adilet2109/current-sensor/README.md

# current-sensor
Bare-metal code base for current sensor board
