adilet2109/current-sensor/hardware/kicad_pulse_supply-rev-C/pcbway_production/T-B5W519245A-3sets-cc_laser_supply_rev-B.kicad_pcb_bom(2024-01-31).xls

PCBWay Bom Quotation, Product No.:T-B5W519245A
Item # | *Designator | *Qty | *Mfg Part # | Description / Value | *Package/Footprint | Mounting Type | Substitute | Assembly requirement | *Unit Price(3 sets) | *Total | *Delivery Time | *Actual Purchase Mfg Part # | *PCBWay Note | Customer Reply | PCBWay Update
1 | C1, C3 | 2 |  | 10u『 』10 µF +/- 20% Ceramic Capacitor | C_0805_2012Metric_Pad1.18x1.45mm_HandSolder | smt |  |  | $0.093 | $0.558 |  | CC0805MRX5R5BB106 |  | OK
2 | C10, C11, C12, C8, C9 | 5 | C5750X7R1V476M230KC | 47u『 』47 µF ±20% 35V Ceramic Capacitor X7R 2220 (5750 Metric) | C_2220_5650Metric | smt | NO |  | $5.501 | $82.515 | 7-10 Workdays
3 | C13 | 1 |  | 22m | CP_Radial_D35.0mm_P10.00mm_SnapIn | tht |  | dnp |  |  |  |  | [DNP不要贴]; | OK
4 | C14, C23, C24, C29, C32, C35 | 6 |  | 100n『 』0.1 µF +/- 20% Ceramic Capacitor | C_0603_1608Metric_Pad1.08x0.95mm_HandSolder | smt |  |  | $0.023 | $0.414 |  | CC0603MRX7R9BB104 |  | OK
5 | C15, C16, C20, C5, C53, C57 | 6 |  | 1u『 』1 µF +/- 20% Ceramic Capacitor | C_0603_1608Metric_Pad1.08x0.95mm_HandSolder | smt |  |  | $0.039 | $0.702 |  | CC0603MRX5R5BB105 |  | No, use UMK107BJ105KA-T or other 25V
6 | C17, C18, C2, C39, C4, C40, C41, C42, C43, C51, C52, C59, C6, C7 | 14 |  | 0u1『 』0.1 µF +/- 20% Ceramic Capacitor | C_0603_1608Metric_Pad1.08x0.95mm_HandSolder | smt |  |  | $0.010 | $0.420 |  | CC0603MRX7R8BB104 |  | OK
7 | C19, C21, C22 | 3 |  | 4u7『 』4.7 µF +/- 20% Ceramic Capacitor | C_0805_2012Metric_Pad1.18x1.45mm_HandSolder | smt |  |  | $0.125 | $1.125 |  | CC0805MKX7R8BB475 |  | OK
8 | C25, C26, C30, C33, C36 | 5 |  | 1u5『 』1.5 µF +/- 20% Ceramic Capacitor | C_0603_1608Metric_Pad1.08x0.95mm_HandSolder | smt |  |  | $0.060 | $0.900 |  | TCC0603X5R155M250CT |  | OK if 25V or higher. If not use C1608X5R1E155K080AB
9 | C27, C28, C31, C34, C37 | 5 |  | 10n『 』10 nF +/- 20% Ceramic Capacitor | C_0603_1608Metric_Pad1.08x0.95mm_HandSolder | smt |  |  | $0.442 | $6.630 |  | CX0603MRX7R9BB103 |  | OK
10 | C38 | 1 |  | 4u7『 』4.7 µF +/- 20% Ceramic Capacitor | C_0603_1608Metric_Pad1.08x0.95mm_HandSolder | smt |  |  | $0.324 | $0.972 |  | CC0603MRX7R5BB475 |  | NO, use 25V or C1608X5R1E475K080AC
11 | C44, C54, C55, C56 | 4 |  | 10u『 』10 µF +/- 20% Ceramic Capacitor | C_1206_3216Metric_Pad1.33x1.80mm_HandSolder | smt |  |  | $0.082 | $0.984 |  | CC1206MRY5V6BB106 |  | NO, use 25V or CL31A106KBHNNNE
12 | C45 | 1 | EEH-ZA1H680P | 68u『 』68 µF 50 V Aluminum - Polymer Capacitors Radial, Can - SMD 30mOhm 10000 Hrs @ 105°C | PCAP_EEHZ_F_PAN | smt | YES |  | $1.008 | $3.024
13 | C46, C49 | 2 |  | 0u1『 』0.1 µF +/- 20% Ceramic Capacitor | C_0402_1005Metric_Pad0.74x0.62mm_HandSolder | smt |  |  | $0.035 | $0.210 |  | CC0402MRY5V6BB104 |  | OK
14 | C47 | 1 | CGA2B2C0G1H101J050BA | 100p『 』100 pF ±5% 50V Ceramic Capacitor C0G, NP0 0402 (1005 Metric) | C_0402_1005Metric_Pad0.74x0.62mm_HandSolder | smt | YES |  | $0.139 | $0.417
15 | C48 | 1 | CGA2B2X7R1H472K050BE | 4700p『 』4700 pF ±10% 50V Ceramic Capacitor X7R 0402 (1005 Metric) | C_0402_1005Metric_Pad0.74x0.62mm_HandSolder | smt | YES |  | $0.412 | $1.236
16 | C50 | 1 |  | 0u22『 』0.22 µF +/- 20% Ceramic Capacitor | C_0603_1608Metric_Pad1.08x0.95mm_HandSolder | smt |  |  | $0.050 | $0.150 |  | CC0603MRX7R6BB224 |  | OK
17 | C58 | 1 | EEHZK1V101XP | 100u『 』100 µF 35 V Aluminum - Polymer Capacitors Radial, Can - SMD 35mOhm 4000 Hrs @ 125°C | CP_Elec_6.3x5.8 | smt | YES |  | $0.787 | $2.361
18 | D1 | 1 |  | PWR『 』red led | LED_0603_1608Metric_Pad1.05x0.95mm_HandSolder | smt |  |  | $0.323 | $0.969 |  | LTST-C191KRKT |  | OK
19 | D10, D11, D12, D13, D14, D15, D16, D17, D8, D9 | 10 | BAT17E6327HTSA1 | BAT17『 』RF Diode Schottky - Single 4V 130 mA 150 mW PG-SOT23 | SOT-23 | smt | NO |  | $0.128 | $3.840
20 | D2 | 1 | MBR120LSFT1G | MBR120『 』Diode 20 V 1A Surface Mount SOD-123FL | D_SOD-123F | smt | YES |  | $0.340 | $1.020
21 | D3 | 1 |  | TX『 』blue led | LED_0603_1608Metric_Pad1.05x0.95mm_HandSolder | smt |  |  | $0.388 | $1.164 |  | LTST-C191TBKT |  | OK
22 | D4 | 1 |  | RX『 』green led | LED_0603_1608Metric_Pad1.05x0.95mm_HandSolder | smt |  |  | $0.294 | $0.882 |  | LTST-C193TGKT-5A |  | OK
23 | D5, D6 | 2 |  | 100V 200mA | D_SOD-323F | smt |  | dnp |  |  |  |  | [DNP不要贴]; | OK
24 | D7 | 1 | SMAZ24-13-F | 24V 1W『 』Zener Diode 24 V 1 W ±5% Surface Mount SMA | D_SMA | smt | YES |  | $0.169 | $0.507
25 | FB1, FB2 | 2 |  | 330R 700mA『 』FERRITE BEAD 330 OHM 0402 1LN | C_0402_1005Metric_Pad0.74x0.62mm_HandSolder | smt |  |  |  |  |  |  | pls provide exact part number | TDK MPZ1005S331ETD25
26 | J1 | 1 | 10118194-0001LF | USB_B_Micro『 』USB - micro B USB 2.0 Receptacle Connector 5 Position Surface Mount, Right Angle; Through Hole | USB_Micro-B_Amphenol_10118194_Horizontal | smt | NO |  | $0.424 | $1.272
27 | J2 | 1 |  | SIG_EXT | BNC_Molex_0731375003 | tht |  | dnp |  |  |  |  | [DNP不要贴]; | Change: populate with Molex 0731375003
28 | J3 | 1 |  | OPT_PWR | BNC_Molex_0731375003 | tht |  | dnp |  |  |  |  | [DNP不要贴]; | Change: populate with Molex 0731375004
29 | JP1 | 1 |  | SIG_SEL | PinHeader_1x03_P2.54mm_Vertical | tht |  | dnp |  |  |  |  | [DNP不要贴]; | Change: populate Harwin M20-9990345 or similar
30 | JP2 | 1 |  | VIN_SEL | PinHeader_1x03_P2.54mm_Vertical | tht |  | dnp |  |  |  |  | [DNP不要贴]; | Change: populate Harwin M20-9990345 or similar
31 | JP3 | 1 |  | VCAP_SEL | custom_jumper | smt |  | dnp |  |  |  |  | [DNP不要贴]; | OK
32 | L1 | 1 | XAL7070-472MEC | 4u7『 』4.7 µH Shielded Molded Inductor 13.6 A 14.26mOhm Max Nonstandard | L_Coilcraft_XAL7070-XXX | smt | NO |  | $2.144 | $6.432
33 | Q1, Q2 | 2 | MMBT2222 | MMBT2222*『 』Bipolar (BJT) Transistor NPN 30 V 600 mA 250MHz 350 mW Surface Mount SOT-23-3 | SOT-23 | smt | YES |  |  |  |  |  | The part is incomplete,pls provide exact part number | MMBT2222LT1G or MMBT2222ALT1G
34 | Q3 | 1 | GAN7R0-150LBEZ | GAN7R0-150LBE『 』N-Channel 150 V 28A 28W Surface Mount 3-FCLGA (3.2x2.2) | 3-FCLGA_3.2x2.2mm | smt | NO |  | $4.244 | $12.732 | 7-10 Workdays
35 | R1, R14, R2, R24, R25, R32, R37, R42, R5 | 9 |  | 10k『 』Resistor 5% 1/16W | R_0603_1608Metric_Pad0.98x0.95mm_HandSolder | smt |  |  | $0.005 | $0.135 |  | RC0603JR-0710KL | ±5%,100mW,Ok? | OK
36 | R10, R11 | 2 | CSRN2010FKR300 | 0R3『 』300 mOhms ±1% 1W Chip Resistor 2010 (5025 Metric) Current Sense Thick Film | R_2010_5025Metric_Pad1.40x2.65mm_HandSolder | smt | NO |  | $0.784 | $4.704 | 7-10 Workdays
37 | R12, R13 | 2 |  | 10『 』Resistor 5% 1/16W | R_0805_2012Metric_Pad1.20x1.40mm_HandSolder | smt |  |  | $0.050 | $0.300 |  | RC0603JR-0710RL | ±5%,100mW,Ok? | OK
38 | R15, R16 | 2 | CSRN2010FK60L0 | 0R06『 』60 mOhms ±1% 1W Chip Resistor 2010 (5025 Metric) Current Sense Thick Film | R_2010_5025Metric_Pad1.40x2.65mm_HandSolder | smt | NO |  | $0.599 | $3.594
39 | R17, R18 | 2 | PE1206DRM070R03L | 0R03『 』30 mOhms ±0.5% 0.25W, 1/4W Chip Resistor 1206 (3216 Metric) Automotive AEC-Q200, Current Sense Metal Film | R_1206_3216Metric_Pad1.30x1.75mm_HandSolder | smt | NO |  | $1.188 | $7.128
40 | R19, R20 | 2 | FC4TR015DER | 0R015『 』15 mOhms ±0.5% 0.5W, 1/2W Chip Resistor 1206 (3216 Metric) Current Sense Metal Foil | R_1206_3216Metric_Pad1.30x1.75mm_HandSolder | smt | NO |  | $0.945 | $5.670 | 7-10 Workdays
41 | R21 | 1 |  | 0『 』Resistor 5% 1/16W | R_0603_1608Metric_Pad0.98x0.95mm_HandSolder | smt |  |  | $0.064 | $0.192 |  | AC0603JR-070RL | ±5%,100mW,Ok? | OK
42 | R22, R23, R31, R36, R41, R6, R7 | 7 |  | 2k2『 』Resistor 5% 1/16W | R_0603_1608Metric_Pad0.98x0.95mm_HandSolder | smt |  |  | $0.006 | $0.126 |  | RC0603JR-072K2L | ±5%,100mW,Ok? | OK
43 | R26, R33, R38, R4, R43, R8, R9 | 7 |  | 1k『 』Resistor 5% 1/16W | R_0603_1608Metric_Pad0.98x0.95mm_HandSolder | smt |  |  | $0.009 | $0.189 |  | AC0603JR-071KL | ±5%,100mW,Ok? | OK
44 | R27, R28, R34, R39, R44 | 5 |  | 1M『 』Resistor 5% 1/16W | R_0603_1608Metric_Pad0.98x0.95mm_HandSolder | smt |  |  | $0.009 | $0.135 |  | RC0603JR-071ML | ±5%,100mW,Ok? | OK
45 | R29, R30, R35, R40, R45 | 5 |  | 22『 』Resistor 5% 1/16W | R_0603_1608Metric_Pad0.98x0.95mm_HandSolder | smt |  |  | $0.010 | $0.150 |  | RC0603JR-0722RL | ±5%,100mW,Ok? | OK
46 | R3 | 1 |  | 100k『 』Resistor 5% 1/16W | R_0603_1608Metric_Pad0.98x0.95mm_HandSolder | smt |  |  | $0.052 | $0.156 |  | AC0603JR-07100KL | ±5%,100mW,Ok? | OK
47 | R46 | 1 |  | 102k『 』Resistor 5% 1/16W | R_0603_1608Metric_Pad0.98x0.95mm_HandSolder | smt |  |  |  |  |  |  | pls provide exact part number | RC0603FR-07102KL
48 | R47 | 1 |  | 27k4『 』Resistor 5% 1/16W | R_0603_1608Metric_Pad0.98x0.95mm_HandSolder | smt |  |  |  |  |  |  | pls provide exact part number | RMCF0603FT27K4
49 | R48 | 1 |  | 49k9『 』Resistor 5% 1/16W | R_0603_1608Metric_Pad0.98x0.95mm_HandSolder | smt |  |  |  |  |  |  | pls provide exact part number | RC0603FR-0749K9L
50 | R49 | 1 |  | 150k『 』Resistor 5% 1/16W | R_0603_1608Metric_Pad0.98x0.95mm_HandSolder | smt |  |  | $0.042 | $0.126 |  | AC0603JR-07150KL |  | OK
51 | R50, R51 | 2 |  | 10『 』Resistor 5% 1/16W | R_0603_1608Metric_Pad0.98x0.95mm_HandSolder | smt |  |  | $0.050 | $0.300 |  | RC0603JR-0710RL | ±5%,100mW,Ok? | OK
52 | R52 | 1 | CRF1206-FZ-R010ELF | 10m『 』10 mOhms ±1% 1W Chip Resistor 1206 (3216 Metric) Automotive AEC-Q200, Current Sense, Moisture Resistant Metal Element | R_1206_3216Metric_Pad1.30x1.75mm_HandSolder | smt | NO |  | $0.829 | $2.487
53 | RV1 | 1 | 3214X-1-202E | 2k『 』2 kOhms 0.25W, 1/4W Gull Wing Surface Mount Trimmer Potentiometer Cermet 5.0 Turn Top Adjustment | Potentiometer_Bourns_3214X_Vertical | smt | NO |  | $3.635 | $10.905 | 7-10 Workdays
54 | SW1 | 1 | KMR211GLFS | KMR211GLFS『 』SWITCH TACTILE SPST-NO 0.05A 32V | SW_Push_1P1T-SH_NO_CK_KMR2xxG | smt | YES |  | $0.737 | $2.211
55 | TP1 | 1 |  | SCL | Keystone-1502-2 | tht |  | dnp |  |  |  |  | [DNP不要贴]; | Change: populate with Keystone 1502-2
56 | TP10, TP16, TP4 | 3 |  | GND | Keystone-1502-2 | tht |  | dnp |  |  |  |  | [DNP不要贴]; | Change: populate with Keystone 1502-2
57 | TP11 | 1 |  | 5A_OUT | Keystone-1502-2 | tht |  | dnp |  |  |  |  | [DNP不要贴]; | Change: populate with Keystone 1502-2
58 | TP12 | 1 |  | 10A_OUT | Keystone-1502-2 | tht |  | dnp |  |  |  |  | [DNP不要贴]; | Change: populate with Keystone 1502-2
59 | TP13 | 1 |  | 20A_OUT | Keystone-1502-2 | tht |  | dnp |  |  |  |  | [DNP不要贴]; | Change: populate with Keystone 1502-2
60 | TP14 | 1 |  | 5V | Keystone-1502-2 | tht |  | dnp |  |  |  |  | [DNP不要贴]; | Change: populate with Keystone 1502-2
61 | TP15 | 1 |  | EXT_VIN | Keystone-1502-2 | tht |  | dnp |  |  |  |  | [DNP不要贴]; | Change: populate with Keystone 1502-2
62 | TP17 | 1 |  | ADC_1A | Keystone-1502-2 | tht |  | dnp |  |  |  |  | [DNP不要贴]; | Change: populate with Keystone 1502-2
63 | TP18 | 1 |  | OPT_PEAK | Keystone-1502-2 | tht |  | dnp |  |  |  |  | [DNP不要贴]; | Change: populate with Keystone 1502-2
64 | TP19 | 1 |  | ADC_5A | Keystone-1502-2 | tht |  | dnp |  |  |  |  | [DNP不要贴]; | Change: populate with Keystone 1502-2
65 | TP2 | 1 |  | SDA | Keystone-1502-2 | tht |  | dnp |  |  |  |  | [DNP不要贴]; | Change: populate with Keystone 1502-2
66 | TP20 | 1 |  | ADC_10A | Keystone-1502-2 | tht |  | dnp |  |  |  |  | [DNP不要贴]; | Change: populate with Keystone 1502-2
67 | TP21 | 1 |  | ADC_20A | Keystone-1502-2 | tht |  | dnp |  |  |  |  | [DNP不要贴]; | Change: populate with Keystone 1502-2
68 | TP22 | 1 |  | OPT_RAW | Keystone-1502-2 | tht |  | dnp |  |  |  |  | [DNP不要贴]; | Change: populate with Keystone 1502-2
69 | TP23 | 1 |  | TPS_VCAP | TestPoint_Pad_D2.5mm | tht |  | dnp |  |  |  |  | [DNP不要贴]; | OK
70 | TP3 | 1 |  | VCAP_IN | Keystone-1502-2 | tht |  | dnp |  |  |  |  | [DNP不要贴]; | Change: populate with Keystone 1502-2
71 | TP5 | 1 |  | DUT+ | Keystone-1502-2 | tht |  | dnp |  |  |  |  | [DNP不要贴]; | Change: populate with Keystone 1502-2
72 | TP6 | 1 |  | VGATE | Keystone-1502-2 | tht |  | dnp |  |  |  |  | [DNP不要贴]; | Change: populate with Keystone 1502-2
73 | TP7 | 1 |  | DUT- | Keystone-1502-2 | tht |  | dnp |  |  |  |  | [DNP不要贴]; | Change: populate with Keystone 1502-2
74 | TP8 | 1 |  | 1A_OUT | Keystone-1502-2 | tht |  | dnp |  |  |  |  | [DNP不要贴]; | Change: populate with Keystone 1502-2
75 | TP9 | 1 |  | SIG_EXT | Keystone-1502-2 | tht |  | dnp |  |  |  |  | [DNP不要贴]; | Change: populate with Keystone 1502-2
76 | U1 | 1 | AP2112K-3.3TRG1 | AP2112K-3.3『 』Linear Voltage Regulator IC Positive Fixed 1 Output 600mA SOT-25 | SOT-23-5 | smt | NO |  | $0.193 | $0.579
77 | U10, U11, U7, U8, U9 | 5 | LTC6244CMS8#PBF | LTC6244CMS8『 』CMOS Amplifier 2 Circuit Rail-to-Rail 8-MSOP | MSOP-8_3x3mm_P0.65mm | smt | NO |  | $6.310 | $94.650 | 7-10 Workdays
78 | U12 | 1 | TPS552892RYQR | TPS552892RYQR『 』Buck-Boost Switching Regulator IC Positive Programmable 0.8V 1 Output 5A 21-PowerVFQFN | CONV_TPS552892RYQR | smt | NO |  | $18.695 | $186.950 | 15 Workdays |  | [moq=10]; | OK
79 | U2 | 1 | ESP32-WROOM-32D | ESP32-WROOM-32D | ESP32-WROOM-32D | smt | NO |  | $3.352 | $10.056 |  | ESP32-WROOM-32D-N4 | The part is incomplete，we will supply is ESP32-WROOM-32D-N4，Please confirm. | OK
80 | U3 | 1 | CP2104-F03-GM | CP2104『 』USB Bridge, USB to UART USB 2.0 UART Interface 24-QFN (4x4) | QFN-24-1EP_4x4mm_P0.5mm_EP2.6x2.6mm | smt | NO |  | $2.205 | $6.615
81 | U4 | 1 | MAX4378TAUD+ | MAX4378『 』Current Sense Amplifier 4 Circuit 14-TSSOP | TSSOP-14_4.4x5mm_P0.65mm | smt | NO |  | $6.608 | $19.824 | 7-10 Workdays
82 | U5 | 1 | UCC27611DRVT | UCC27611DRVT『 』Low-Side Gate Driver IC Inverting, Non-Inverting 6-WSON (2x2) | UCC27611DRVT | smt | NO |  | $1.071 | $3.213
83 | U6 | 1 | MCP1703T-5002E/MB | MCP1703T-5002E/MB『 』Linear Voltage Regulator IC Positive Fixed 1 Output 250mA SOT-89-3 | SOT-89-3 | smt | NO |  | $0.670 | $2.010
 |  |  |  |  |  |  |  |  | Component Cost | $493.84
 |  |  |  |  |  |  |  |  | Assembly Cost
 |  |  |  |  |  |  |  |  | PCB Cost
 |  |  |  |  |  |  |  |  | V0 Member 0% off | $0.00
 |  |  |  |  |  |  |  |  | All Total 3 Sets | $493.84
