adilet2109/current-sensor/(list of files, drawings)

Other design files:
hardware/kicad_pulse_supply-rev-C/Imported cc_laser_supply_rev-B/cc_laser_supply_rev-B(1).PcbDoc
hardware/kicad_pulse_supply-rev-C/Imported cc_laser_supply_rev-B/current_sensing.SchLib
hardware/kicad_pulse_supply-rev-C/Imported cc_laser_supply_rev-B/DW_custom_symbols.SchLib
hardware/kicad_pulse_supply-rev-C/Imported cc_laser_supply_rev-B/DW_Library.PcbLib
hardware/kicad_pulse_supply-rev-C/Imported cc_laser_supply_rev-B/esp32.SchLib
hardware/kicad_pulse_supply-rev-C/Imported cc_laser_supply_rev-B/fet_and_driver.SchLib
hardware/kicad_pulse_supply-rev-C/Imported cc_laser_supply_rev-B/kicad_pulse_supply-rev-C.PcbDoc
hardware/kicad_pulse_supply-rev-C/Imported cc_laser_supply_rev-B/kicad_pulse_supply-rev-C.PrjPcb
hardware/kicad_pulse_supply-rev-C/Imported cc_laser_supply_rev-B/kicad_pulse_supply-rev-C.SchLib
hardware/kicad_pulse_supply-rev-C/Imported cc_laser_supply_rev-B/peak_detect.SchLib
hardware/kicad_pulse_supply-rev-C/Imported cc_laser_supply_rev-B/power_and_usb.SchLib
hardware/kicad_pulse_supply-rev-C/Imported cc_laser_supply_rev-B/untitled.SchLib
