adilet2109/current-sensor/hardware/kicad_pulse_supply-rev-B/kicad_pulse_supply-rev-B.kicad_pcb

## KiCad design hardware/kicad_pulse_supply-rev-B/kicad_pulse_supply-rev-B.kicad_pcb (2024-04-18, an earlier design)

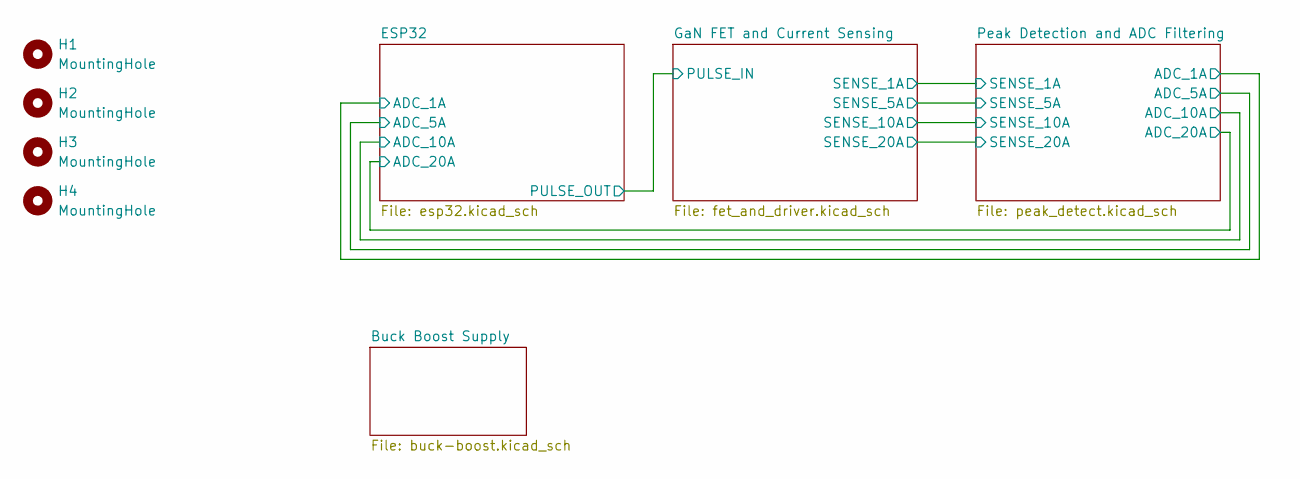
[picture p1: schematic kicad_pulse_supply-rev-B.kicad_sch, LD Current Pulse Supply]

Parts:
H1, H2, H3, H4: MountingHole; MountingHole_3.5mm

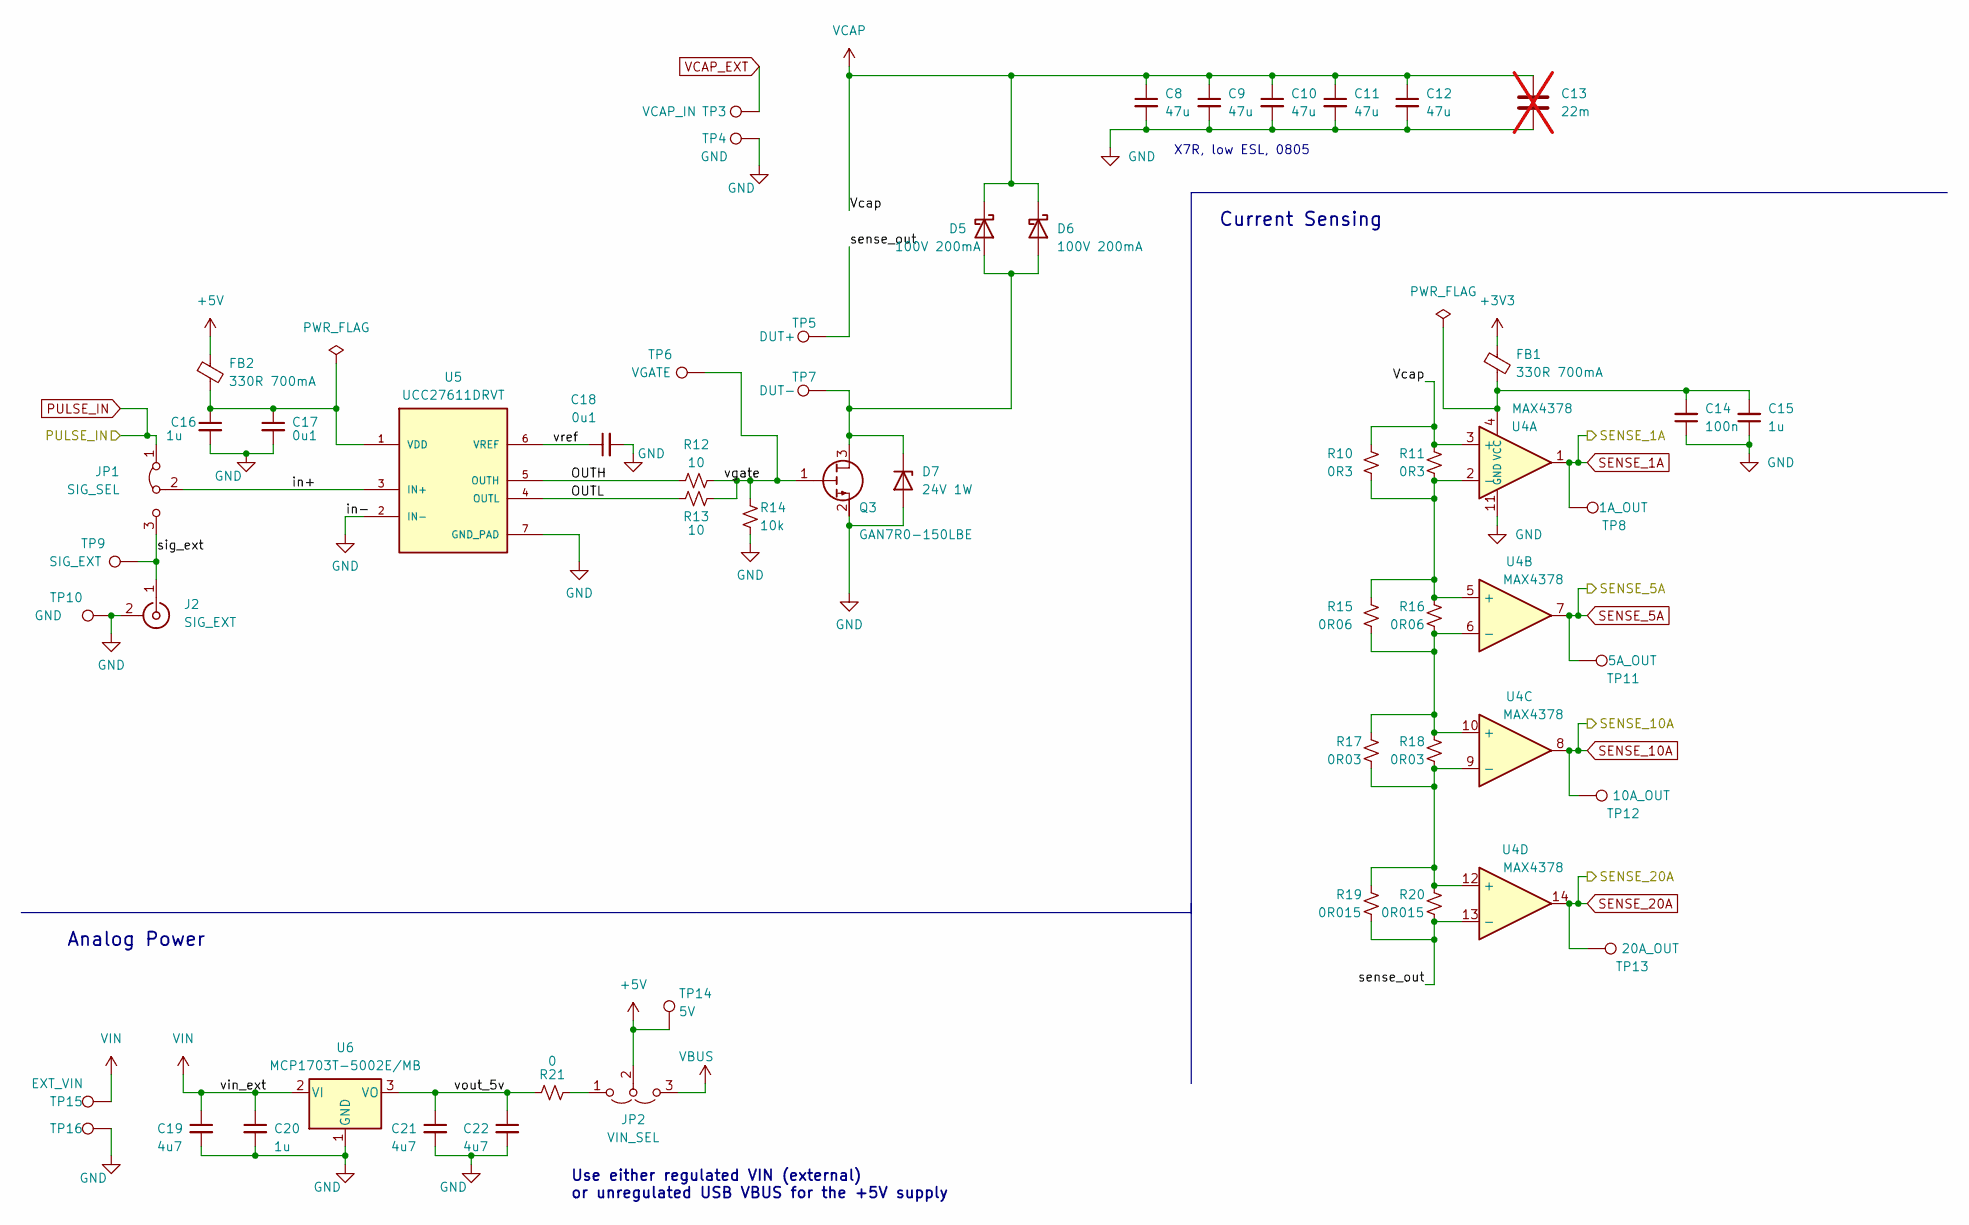
[picture p2: schematic fet_and_driver.kicad_sch]

Parts:
C8, C9, C10, C11, C12: 47u; C_2220_5650Metric; Part No. C5750X7R1V476M230KC
C13: 22m; CP_Radial_D35.0mm_P10.00mm_SnapIn; not fitted
C14: 100n; C_0603_1608Metric_Pad1.08x0.95mm_HandSolder
C15, C16, C20: 1u; C_0603_1608Metric_Pad1.08x0.95mm_HandSolder
C17, C18: 0u1; C_0603_1608Metric_Pad1.08x0.95mm_HandSolder
C19, C21, C22: 4u7; C_0805_2012Metric_Pad1.18x1.45mm_HandSolder
D5, D6: 100V 200mA; D_SOD-323F
D7: 24V 1W; D_SMA
FB1, FB2: 330R 700mA; C_0402_1005Metric_Pad0.74x0.62mm_HandSolder
J2: SIG_EXT; BNC_Molex_0731375003
JP1: SIG_SEL; PinHeader_1x03_P2.54mm_Vertical
JP2: VIN_SEL; PinHeader_1x03_P2.54mm_Vertical
Q3: GAN7R0-150LBE; 3-FCLGA_3.2x2.2mm; Part NXP GAN7R0-150LBE
R10, R11: 0R3; R_2010_5025Metric_Pad1.40x2.65mm_HandSolder
R12, R13: 10; R_0805_2012Metric_Pad1.20x1.40mm_HandSolder
R14: 10k; R_0603_1608Metric_Pad0.98x0.95mm_HandSolder
R15, R16: 0R06; R_2010_5025Metric_Pad1.40x2.65mm_HandSolder
R17, R18: 0R03; R_1206_3216Metric_Pad1.30x1.75mm_HandSolder
R19, R20: 0R015; R_1206_3216Metric_Pad1.30x1.75mm_HandSolder
R21: 0; R_0603_1608Metric_Pad0.98x0.95mm_HandSolder
TP3: VCAP_IN; Keystone-1502-2
TP4, TP10, TP16: GND; Keystone-1502-2
TP5: DUT+; Keystone-1502-2
TP6: VGATE; Keystone-1502-2
TP7: DUT-; Keystone-1502-2
TP8: 1A_OUT; Keystone-1502-2
TP9: SIG_EXT; Keystone-1502-2
TP11: 5A_OUT; Keystone-1502-2
TP12: 10A_OUT; Keystone-1502-2
TP13: 20A_OUT; Keystone-1502-2
TP14: 5V; Keystone-1502-2
TP15: EXT_VIN; Keystone-1502-2
U4: MAX4378; TSSOP-14_4.4x5mm_P0.65mm
U5: UCC27611DRVT
U6: MCP1703T-5002E/MB; SOT-89-3

Connections:
+3V3: FB1.1; also elsewhere on the board
+5V: FB2.1, JP2.2 (C), TP14.1; also elsewhere on the board
/GaN FET and Current Sensing/OUTH: R12.1, U5.5 (OUTH)
/GaN FET and Current Sensing/OUTL: R13.1, U5.4 (OUTL)
/GaN FET and Current Sensing/in+: JP1.2 (C), U5.3 (IN+)
/GaN FET and Current Sensing/sense_out: R19.2, R20.2, TP5.1, U4.13 (-)
/GaN FET and Current Sensing/sig_ext: J2.1 (In), JP1.3 (B), TP9.1
/GaN FET and Current Sensing/vgate: Q3.1 (G), R12.2, R13.2, R14.1, TP6.1
/GaN FET and Current Sensing/vout_5v: C21.1, C22.1, R21.2, U6.3 (VO)
/GaN FET and Current Sensing/vref: C18.1, U5.6 (VREF)
GND: C8.2, C9.2, C10.2, C11.2, C12.2, C13.2, C14.1, C15.1, C16.2, C17.2, C18.2, C19.2, C20.2, C21.2, C22.2, D7.2 (A), J2.2 (Ext), Q3.2 (S), R14.2, TP4.1, TP10.1, TP16.1, U4.11 (GND), U5.2 (IN-), U5.7 (GND_PAD), U6.1 (GND); also elsewhere on the board
unnamed: D5.2 (A), D6.2 (A), D7.1 (K), Q3.3 (D), TP7.1
unnamed: JP2.1 (A), R21.1
unnamed: R10.2, R11.2, R15.1, R16.1, U4.2 (-), U4.5 (+)
unnamed: C14.2, C15.2, FB1.2, U4.4 (VCC)
unnamed: R15.2, R16.2, R17.1, R18.1, U4.6 (-), U4.10 (+)
unnamed: R17.2, R18.2, R19.1, R20.1, U4.9 (-), U4.12 (+)
unnamed: C16.1, C17.1, FB2.2, U5.1 (VDD)
PULSE_IN: JP1.1 (A); also elsewhere on the board
SENSE_1A: TP8.1, U4.1; also elsewhere on the board
SENSE_5A: TP11.1, U4.7; also elsewhere on the board
SENSE_10A: TP12.1, U4.8; also elsewhere on the board
SENSE_20A: TP13.1, U4.14; also elsewhere on the board
VBUS: JP2.3 (B); also elsewhere on the board
VCAP: C8.1, C9.1, C10.1, C11.1, C12.1, C13.1, D5.1 (K), D6.1 (K), R10.1, R11.1, U4.3 (+); also elsewhere on the board
VCAP_EXT: TP3.1; also elsewhere on the board
VIN: C19.1, C20.1, TP15.1, U6.2 (VI)

Notes on the sheet:
Use either regulated VIN (external) or unregulated USB VBUS for the +5V supply
Current Sensing
X7R, low ESL, 0805
Analog Power

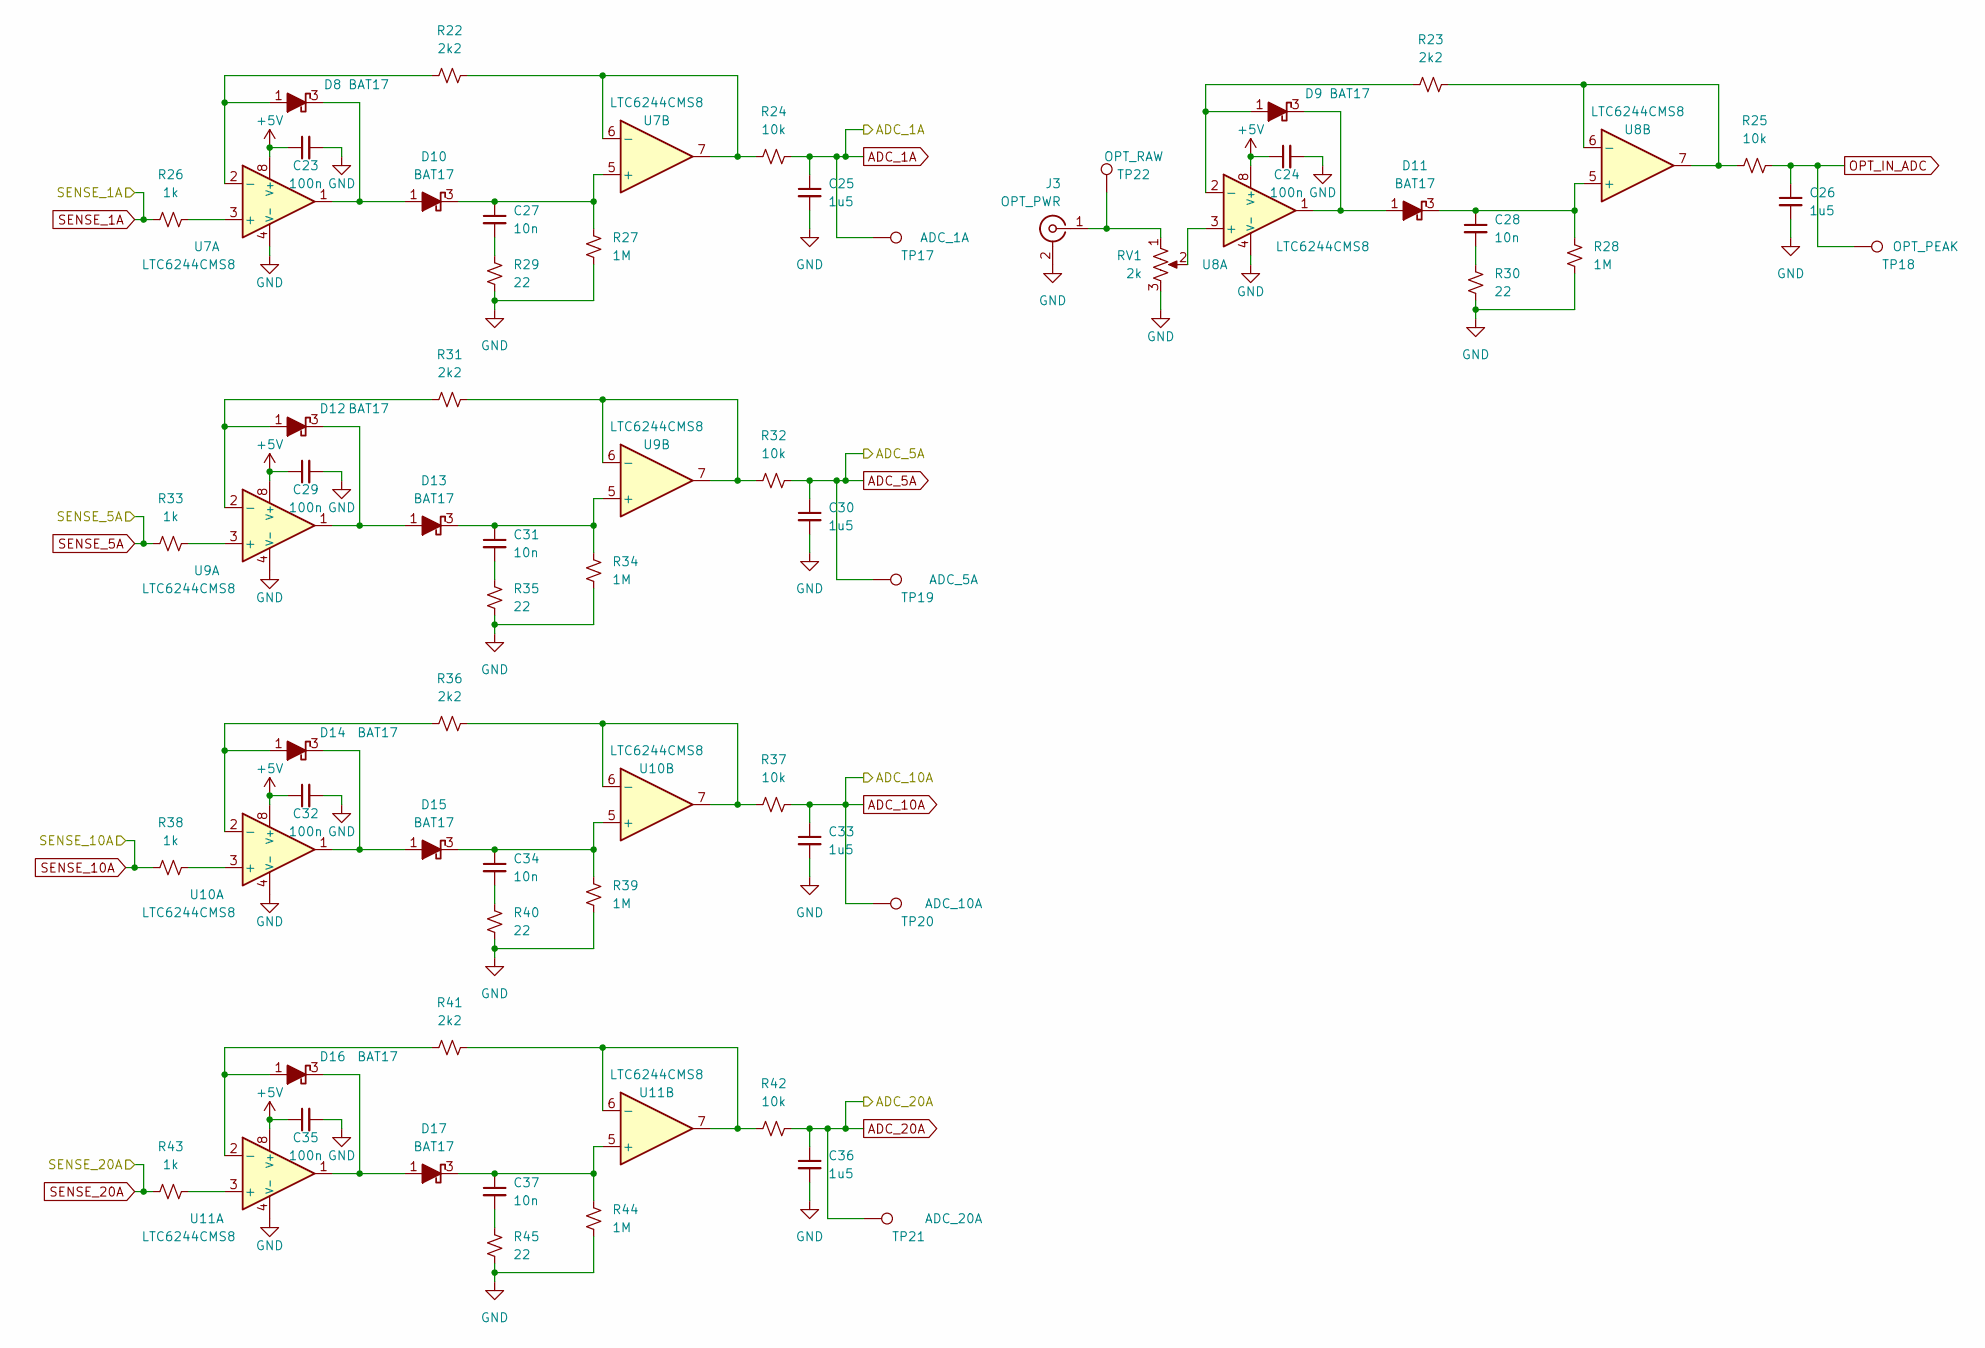
[picture p3: schematic peak_detect.kicad_sch]

Parts:
C23, C24, C29, C32, C35: 100n; C_0603_1608Metric_Pad1.08x0.95mm_HandSolder
C25, C26, C30, C33, C36: 1u5; C_0603_1608Metric_Pad1.08x0.95mm_HandSolder
C27, C28, C31, C34, C37: 10n; C_0603_1608Metric_Pad1.08x0.95mm_HandSolder
D8, D9, D10, D11, D12, D13, D14, D15, D16, D17: BAT17; SOT-23
J3: OPT_PWR; BNC_Molex_0731375003
R22, R23, R31, R36, R41: 2k2; R_0603_1608Metric_Pad0.98x0.95mm_HandSolder
R24, R25, R32, R37, R42: 10k; R_0603_1608Metric_Pad0.98x0.95mm_HandSolder
R26, R33, R38, R43: 1k; R_0603_1608Metric_Pad0.98x0.95mm_HandSolder
R27, R28, R34, R39, R44: 1M; R_0603_1608Metric_Pad0.98x0.95mm_HandSolder
R29, R30, R35, R40, R45: 22; R_0603_1608Metric_Pad0.98x0.95mm_HandSolder
RV1: 2k; Potentiometer_Bourns_3214X_Vertical; Part No. 3214X-1-202E
TP17: ADC_1A; Keystone-1502-2
TP18: OPT_PEAK; Keystone-1502-2
TP19: ADC_5A; Keystone-1502-2
TP20: ADC_10A; Keystone-1502-2
TP21: ADC_20A; Keystone-1502-2
TP22: OPT_RAW; Keystone-1502-2
U7, U8, U9, U10, U11: LTC6244CMS8; MSOP-8_3x3mm_P0.65mm

Connections:
+5V: C23.1, C24.1, C29.1, C32.1, C35.1, U7.8 (V+), U8.8 (V+), U9.8 (V+), U10.8 (V+), U11.8 (V+); also elsewhere on the board
ADC_1A: C25.1, R24.2, TP17.1; also elsewhere on the board
ADC_5A: C30.1, R32.2, TP19.1; also elsewhere on the board
ADC_10A: C33.1, R37.2, TP20.1; also elsewhere on the board
ADC_20A: C36.1, R42.2, TP21.1; also elsewhere on the board
GND: C23.2, C24.2, C25.2, C26.2, C29.2, C30.2, C32.2, C33.2, C35.2, C36.2, J3.2 (Ext), R27.2, R28.2, R29.2, R30.2, R34.2, R35.2, R39.2, R40.2, R44.2, R45.2, RV1.3, U7.4 (V-), U8.4 (V-), U9.4 (V-), U10.4 (V-), U11.4 (V-); also elsewhere on the board
unnamed: C27.2, R29.1
unnamed: C28.2, R30.1
unnamed: C31.2, R35.1
unnamed: C34.2, R40.1
unnamed: C37.2, R45.1
unnamed: D8.1 (A), R22.1, U7.2 (-)
unnamed: D9.1 (A), R23.1, U8.2 (-)
unnamed: D8.3 (K), D10.1 (A), U7.1
unnamed: C27.1, D10.3 (K), R27.1, U7.5 (+)
unnamed: D9.3 (K), D11.1 (A), U8.1
unnamed: C28.1, D11.3 (K), R28.1, U8.5 (+)
unnamed: D12.1 (A), R31.1, U9.2 (-)
unnamed: D12.3 (K), D13.1 (A), U9.1
unnamed: C31.1, D13.3 (K), R34.1, U9.5 (+)
unnamed: D14.1 (A), R36.1, U10.2 (-)
unnamed: D14.3 (K), D15.1 (A), U10.1
unnamed: C34.1, D15.3 (K), R39.1, U10.5 (+)
unnamed: D16.1 (A), R41.1, U11.2 (-)
unnamed: D16.3 (K), D17.1 (A), U11.1
unnamed: C37.1, D17.3 (K), R44.1, U11.5 (+)
unnamed: J3.1 (In), RV1.1, TP22.1
unnamed: R26.2, U7.3 (+)
unnamed: R22.2, R24.1, U7.6 (-), U7.7
unnamed: RV1.2, U8.3 (+)
unnamed: R23.2, R25.1, U8.6 (-), U8.7
unnamed: R33.2, U9.3 (+)
unnamed: R31.2, R32.1, U9.6 (-), U9.7
unnamed: R38.2, U10.3 (+)
unnamed: R36.2, R37.1, U10.6 (-), U10.7
unnamed: R43.2, U11.3 (+)
unnamed: R41.2, R42.1, U11.6 (-), U11.7
OPT_IN_ADC: C26.1, R25.2, TP18.1; also elsewhere on the board
SENSE_1A: R26.1; also elsewhere on the board
SENSE_5A: R33.1; also elsewhere on the board
SENSE_10A: R38.1; also elsewhere on the board
SENSE_20A: R43.1; also elsewhere on the board

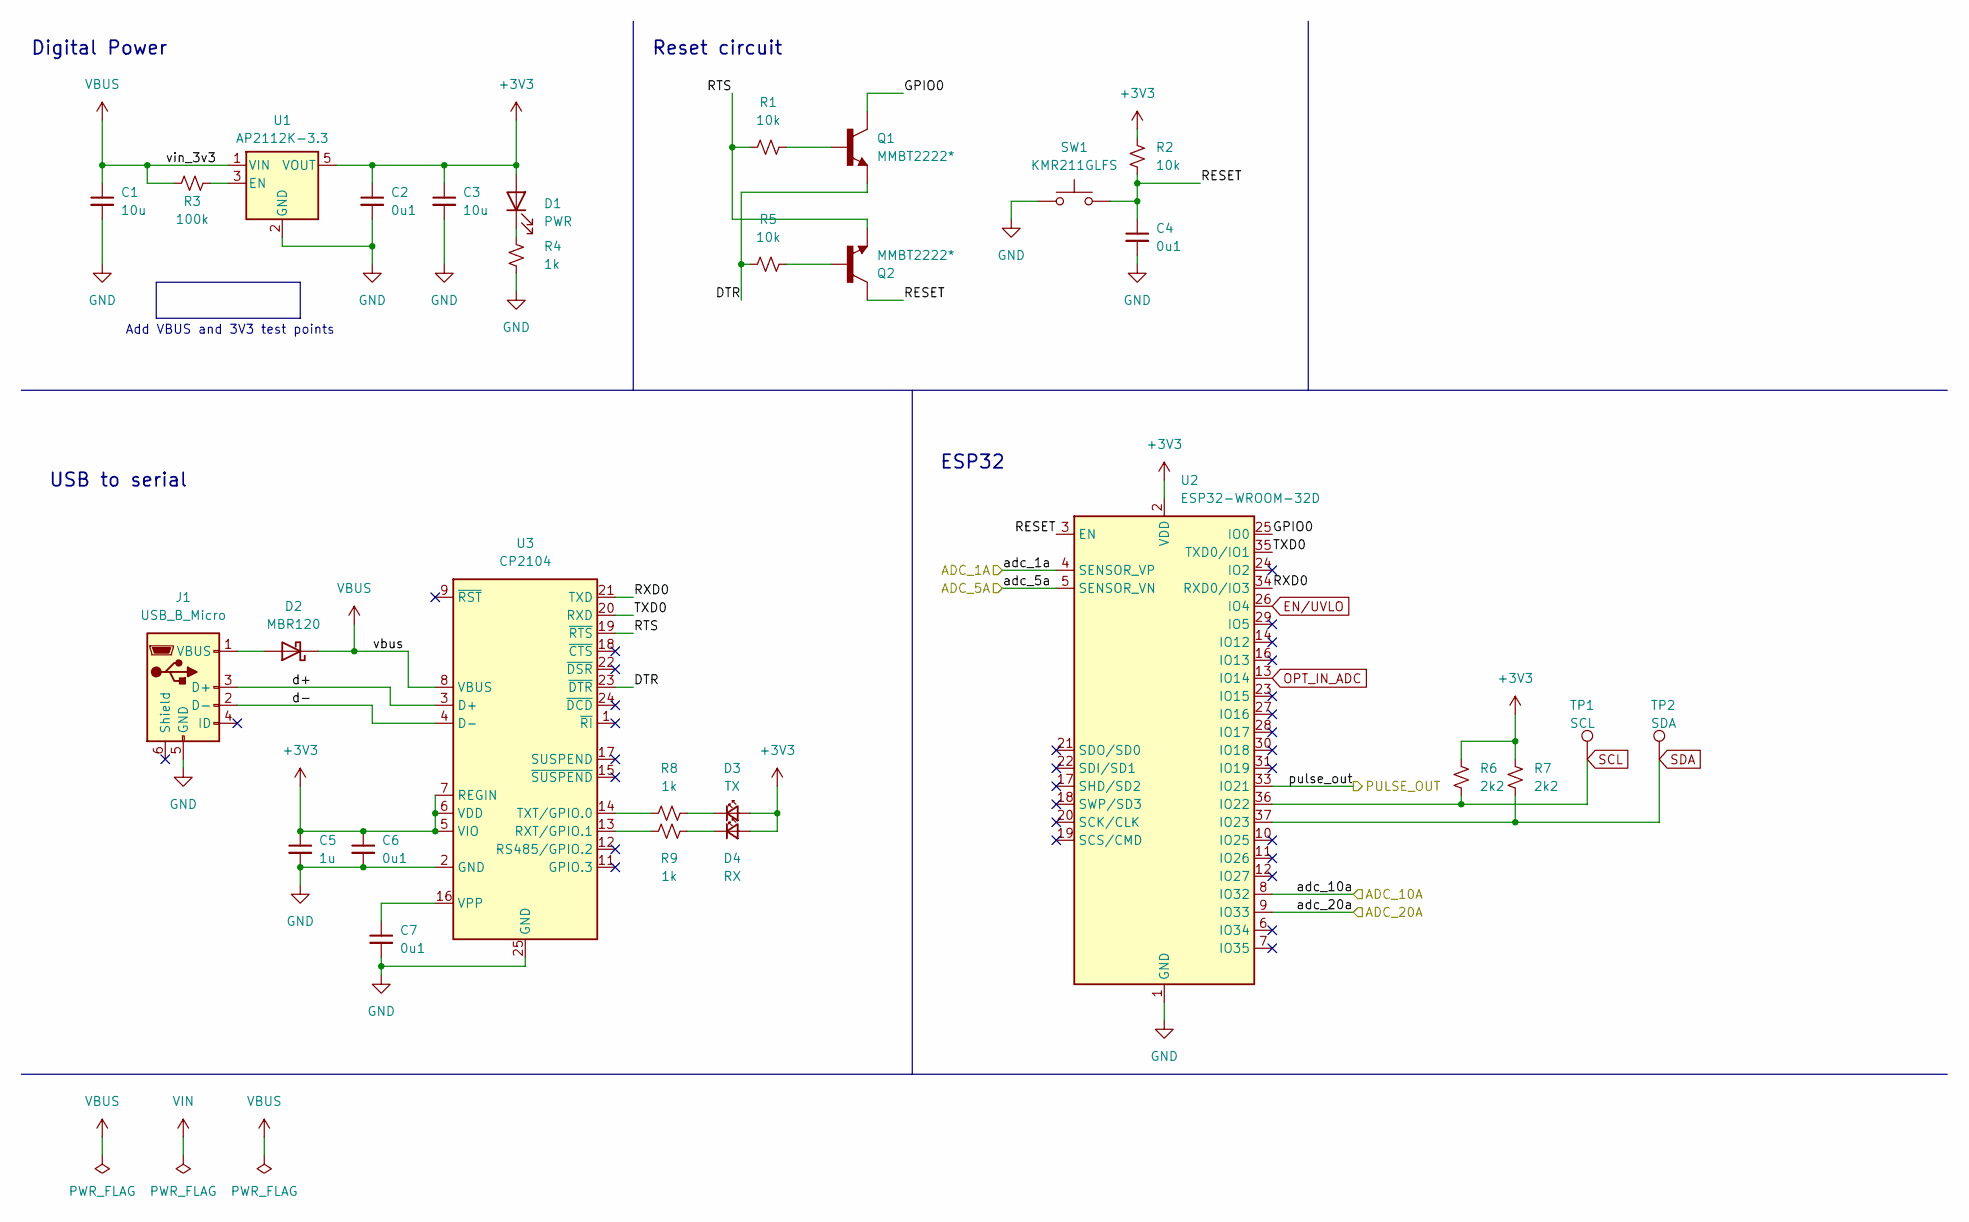
[picture p4: schematic esp32.kicad_sch]

Parts:
C1, C3: 10u; C_0805_2012Metric_Pad1.18x1.45mm_HandSolder
C2, C4, C6, C7: 0u1; C_0603_1608Metric_Pad1.08x0.95mm_HandSolder
C5: 1u; C_0603_1608Metric_Pad1.08x0.95mm_HandSolder
D1: PWR; LED_0603_1608Metric_Pad1.05x0.95mm_HandSolder
D2: MBR120; D_SOD-123F
D3: TX; LED_0603_1608Metric_Pad1.05x0.95mm_HandSolder
D4: RX; LED_0603_1608Metric_Pad1.05x0.95mm_HandSolder
J1: USB_B_Micro; USB_Micro-B_Amphenol_10118194_Horizontal; Part Amphenol 10118294
Q1, Q2: MMBT2222*; SOT-23
R1, R2, R5: 10k; R_0603_1608Metric_Pad0.98x0.95mm_HandSolder
R3: 100k; R_0603_1608Metric_Pad0.98x0.95mm_HandSolder
R4, R8, R9: 1k; R_0603_1608Metric_Pad0.98x0.95mm_HandSolder
R6, R7: 2k2; R_0603_1608Metric_Pad0.98x0.95mm_HandSolder
SW1: KMR211GLFS; SW_Push_1P1T-SH_NO_CK_KMR2xxG
TP1: SCL; Keystone-1502-2; Part Keystone 1502-2
TP2: SDA; Keystone-1502-2; Part Keystone 1502-2
U1: AP2112K-3.3; SOT-23-5
U2: ESP32-WROOM-32D
U3: CP2104; QFN-24-1EP_4x4mm_P0.5mm_EP2.6x2.6mm

Connections:
+3V3: C2.1, C3.1, C5.1, C6.1, D1.2 (A), D3.2 (A), D4.2 (A), R2.2, R6.2, R7.2, U1.5 (VOUT), U2.2 (VDD), U3.5 (VIO), U3.6 (VDD), U3.7 (REGIN); also elsewhere on the board
/ESP32/DTR: Q1.2, R5.1, U3.23 (~DTR)
/ESP32/GPIO0: Q1.3, U2.25 (IO0)
/ESP32/RESET: C4.1, Q2.3, R2.1, SW1.2, U2.3 (EN)
/ESP32/RTS: Q2.2, R1.1, U3.19 (~RTS)
/ESP32/RXD0: U2.34 (RXD0/IO3), U3.21 (TXD)
/ESP32/TXD0: U2.35 (TXD0/IO1), U3.20 (RXD)
/ESP32/d+: J1.3 (D+), U3.3 (D+)
/ESP32/d-: J1.2 (D-), U3.4 (D-)
ADC_1A: U2.4 (SENSOR_VP); also elsewhere on the board
ADC_5A: U2.5 (SENSOR_VN); also elsewhere on the board
ADC_10A: U2.8 (IO32); also elsewhere on the board
ADC_20A: U2.9 (IO33); also elsewhere on the board
EN/UVLO: U2.26 (IO4); also elsewhere on the board
GND: C1.2, C2.2, C3.2, C4.2, C5.2, C6.2, C7.2, J1.5 (GND), R4.1, SW1.1, U1.2 (GND), U2.1 (GND), U2.15 (GND), U2.38 (GND), U2.39 (GND), U3.2 (GND), U3.25 (GND); also elsewhere on the board
unnamed: D1.1 (K), R4.2
unnamed: D2.2 (A), J1.1 (VBUS)
unnamed: D3.1 (K), R8.2
unnamed: D4.1 (K), R9.2
unnamed: Q1.1, R1.2
unnamed: Q2.1, R5.2
unnamed: R3.2, U1.3 (EN)
unnamed: R9.1, U3.13 (RXT/GPIO.1)
unnamed: R8.1, U3.14 (TXT/GPIO.0)
unnamed: C7.1, U3.16 (VPP)
OPT_IN_ADC: U2.13 (IO14); also elsewhere on the board
PULSE_IN: U2.33 (IO21); also elsewhere on the board
SCL: R6.1, TP1.1, U2.36 (IO22); also elsewhere on the board
SDA: R7.1, TP2.1, U2.37 (IO23); also elsewhere on the board
VBUS: C1.1, D2.1 (K), R3.1, U1.1 (VIN), U3.8 (VBUS); also elsewhere on the board

Notes on the sheet:
Add VBUS and 3V3 test points
USB to serial
ESP32
Digital Power
Reset circuit

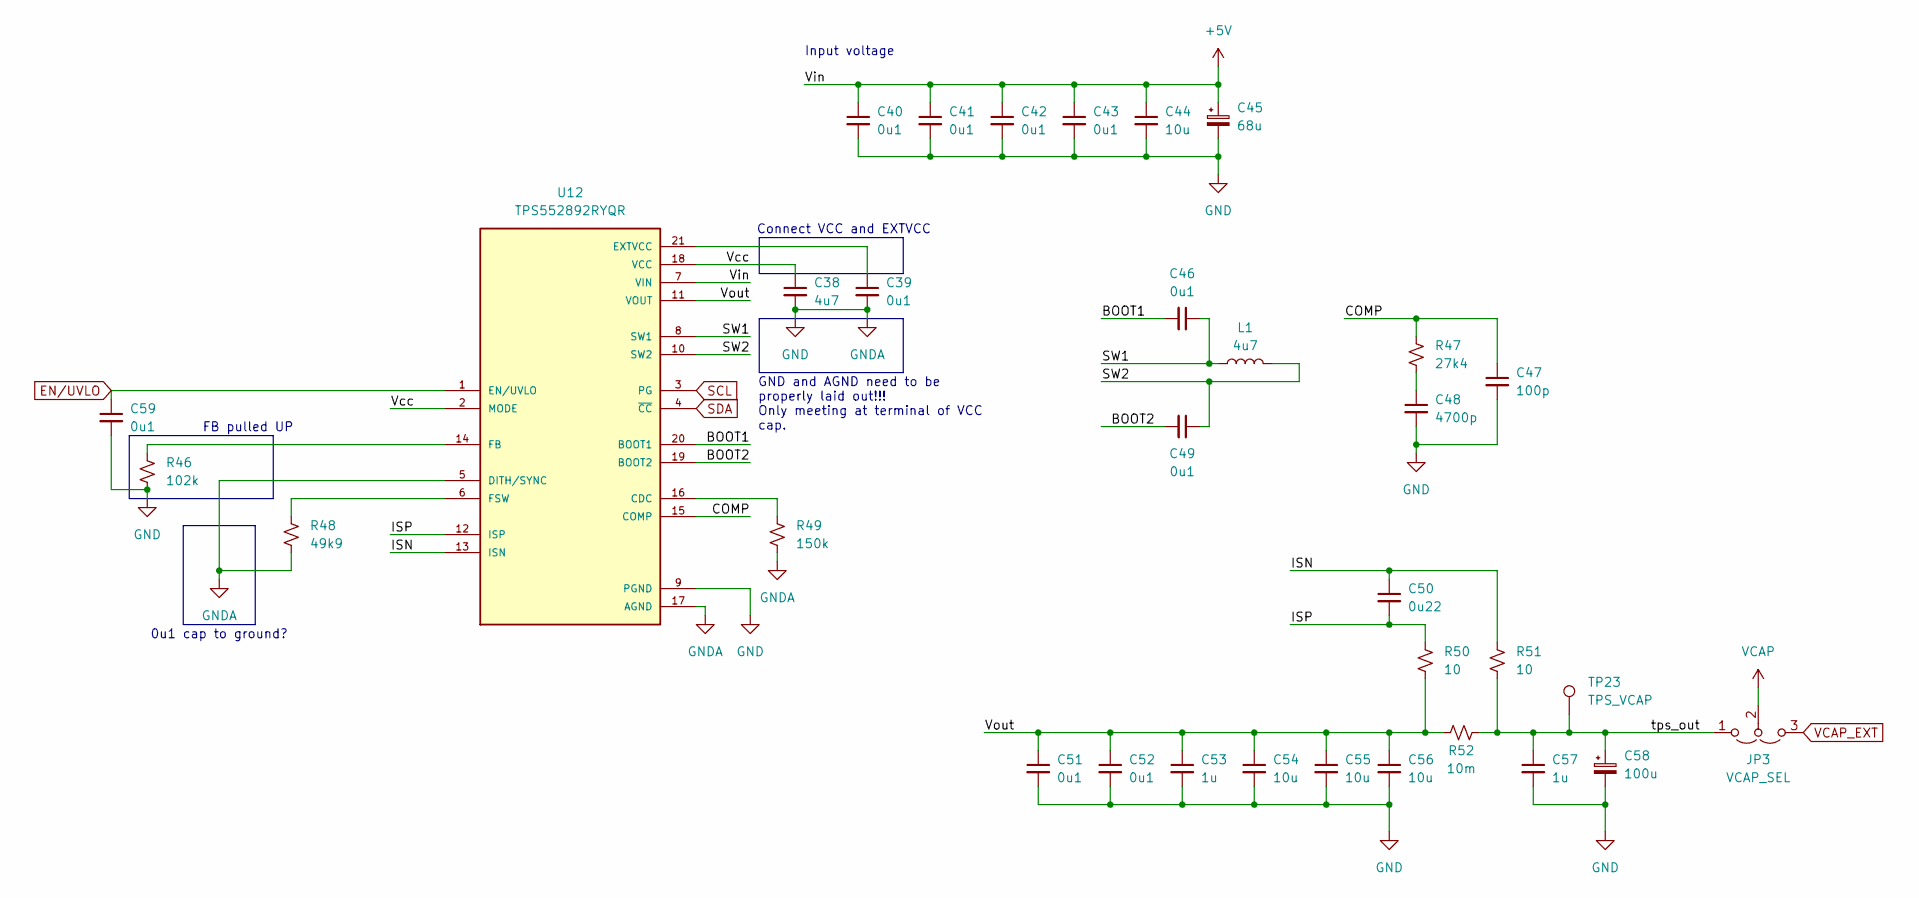
[picture p5: schematic buck-boost.kicad_sch]

Parts:
C38: 4u7; C_0603_1608Metric_Pad1.08x0.95mm_HandSolder
C39, C40, C41, C42, C43, C46, C49, C51, C52, C59: 0u1; C_0603_1608Metric_Pad1.08x0.95mm_HandSolder
C44, C54, C55, C56: 10u; C_1206_3216Metric_Pad1.33x1.80mm_HandSolder
C45: 68u; PCAP_EEHZ_F_PAN; Part No. EEH-ZA1H680P
C47: 100p; C_0402_1005Metric_Pad0.74x0.62mm_HandSolder; Part No. CGA2B2C0G1H101J
C48: 4700p; C_0402_1005Metric_Pad0.74x0.62mm_HandSolder; Part No. CGA2B2X7R1H472K
C50: 0u22; C_0603_1608Metric_Pad1.08x0.95mm_HandSolder
C53, C57: 1u; C_0603_1608Metric_Pad1.08x0.95mm_HandSolder
C58: 100u; CP_Elec_6.3x5.8; Part No. EEHZK1V101XP
JP3: VCAP_SEL; custom_jumper
L1: 4u7; L_Coilcraft_XAL7070-XXX; Part No. XAL7070-472MEC
R46: 102k; R_0603_1608Metric_Pad0.98x0.95mm_HandSolder
R47: 27k4; R_0603_1608Metric_Pad0.98x0.95mm_HandSolder
R48: 49k9; R_0603_1608Metric_Pad0.98x0.95mm_HandSolder
R49: 150k; R_0603_1608Metric_Pad0.98x0.95mm_HandSolder
R50, R51: 10; R_0603_1608Metric_Pad0.98x0.95mm_HandSolder
R52: 10m; R_1206_3216Metric_Pad1.30x1.75mm_HandSolder; Part No. CRF1206-FZ-R010ELF
TP23: TPS_VCAP; TestPoint_Pad_D2.5mm
U12: TPS552892RYQR; CONV_TPS552892RYQR; PARTREV A

Connections:
+5V: C40.1, C41.1, C42.1, C43.1, C44.1, C45.1, U12.7 (VIN); also elsewhere on the board
/Buck Boost Supply/BOOT1: C46.2, U12.20 (BOOT1)
/Buck Boost Supply/BOOT2: C49.2, U12.19 (BOOT2)
/Buck Boost Supply/COMP: C47.1, R47.1, U12.15 (COMP)
/Buck Boost Supply/ISN: C50.1, R51.1, U12.13 (ISN)
/Buck Boost Supply/ISP: C50.2, R50.1, U12.12 (ISP)
/Buck Boost Supply/SW1: C46.1, L1.1, U12.8 (SW1)
/Buck Boost Supply/SW2: C49.1, L1.2, U12.10 (SW2)
/Buck Boost Supply/Vcc: C38.1, U12.2 (MODE), U12.18 (VCC)
/Buck Boost Supply/Vout: C51.1, C52.1, C53.1, C54.1, C55.1, C56.1, R50.2, R52.1, U12.11 (VOUT)
/Buck Boost Supply/tps_out: C57.1, C58.1, JP3.1 (A), R51.2, R52.2, TP23.1
EN/UVLO: C59.1, U12.1 (EN/UVLO); also elsewhere on the board
GND: C38.2, C39.2, C40.2, C41.2, C42.2, C43.2, C44.2, C45.2, C47.2, C48.2, C51.2, C52.2, C53.2, C54.2, C55.2, C56.2, C57.2, C58.2, C59.2, R46.2, R48.2, R49.2, U12.5 (DITH/SYNC), U12.9 (PGND), U12.17 (AGND); also elsewhere on the board
unnamed: C48.1, R47.2
unnamed: R49.1, U12.16 (CDC)
unnamed: C39.1, U12.21 (EXTVCC)
unnamed: R46.1, U12.14 (FB)
unnamed: R48.1, U12.6 (FSW)
SCL: U12.3 (PG); also elsewhere on the board
SDA: U12.4 (~CC); also elsewhere on the board
VCAP: JP3.2 (C); also elsewhere on the board
VCAP_EXT: JP3.3 (B); also elsewhere on the board

Notes on the sheet:
Connect VCC and EXTVCC
Input voltage
GND and AGND need to be properly laid out!!! Only meeting at terminal of VCC cap.
FB pulled UP
0u1 cap to ground?

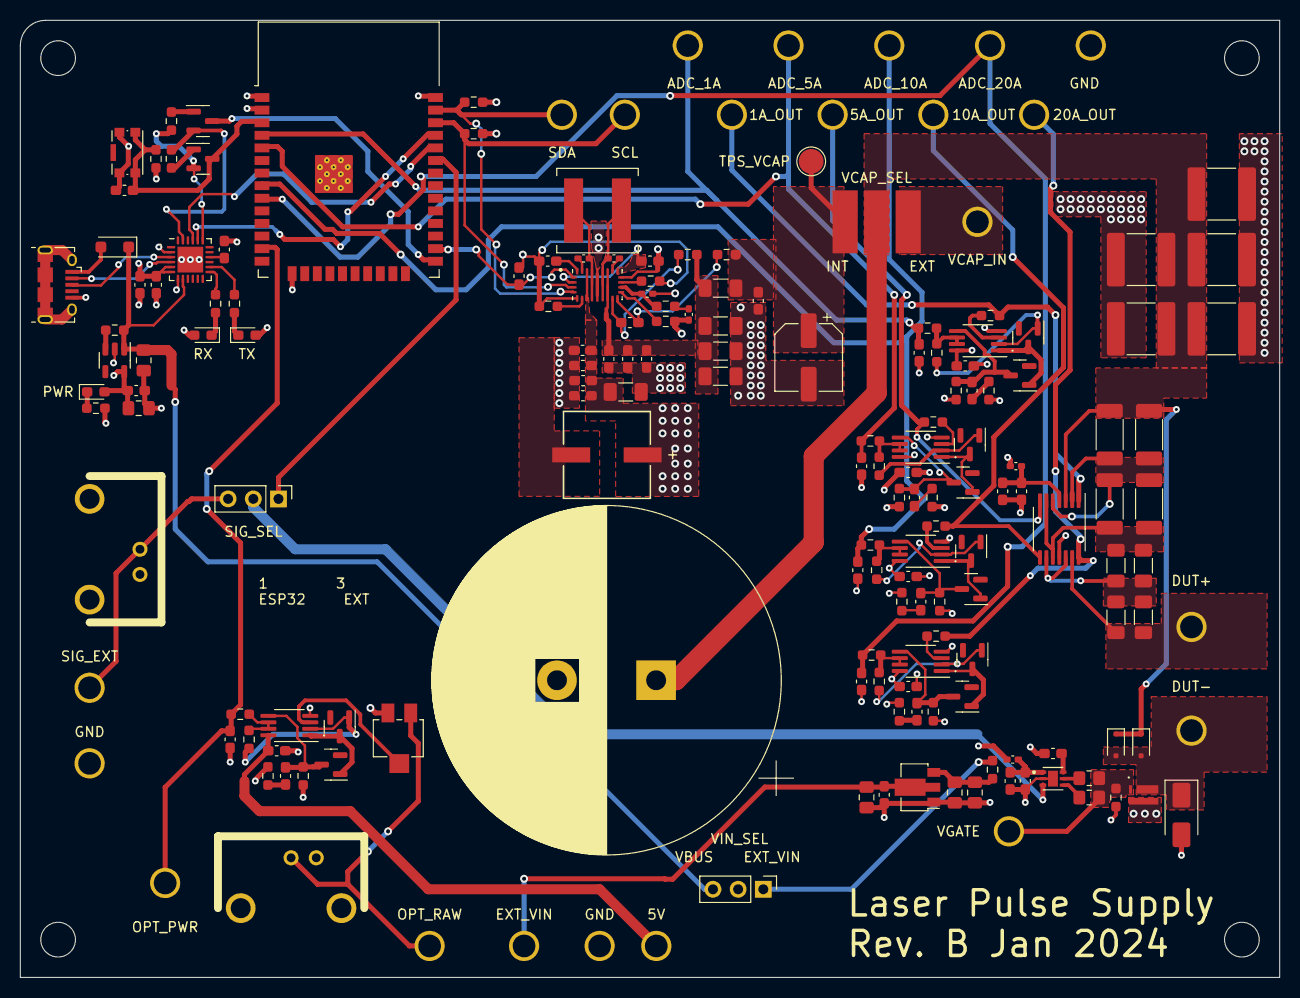
[picture p6: board kicad_pulse_supply-rev-B.kicad_pcb from above]

Board: 4 copper layers, 127.0 x 96.5 mm, 181 parts (0 on the bottom side), 99 nets.
