adilet2109/current-sensor/software/include/pins.h

/*
    Filename:       pins.h
    Date:           08-Mar-2024
    Description:    Pin definitions for the ESP32-WROOM module
*/

#ifndef PINS_H
#define PINS_H

#define PIN_PULSE_OUTPUT 21
#define PIN_ADC_1A 36
#define PIN_ADC_5A 39
#define PIN_ADC_10A 32
#define PIN_ADC_20A 33
#define PIN_ADC_OPT 14
#define ENABLE_PIN 34
#define DECREASE_PIN 25
#define INCREASE_PIN 26
#define TIMER_PIN 32
#define TPS55289_EN_PIN 4

#endif
