adilet2109/current-sensor/(commit log)

2024-02-08 added kicad file
    [DW_Library.PcbLib, DW_custom_symbols.SchLib, T-B5W519245A-3sets-cc_laser_supply_rev-B.kicad_pcb_bom(2024-01-31).xls, buck-boost-supply.kicad_sch, buck-boost.kicad_sch, cc_laser_supply_rev-B(1).PcbDoc, cc_laser_supply_rev-B.kicad_pcb_bom.csv, cc_laser_supply_rev-B.kicad_pcb_positions.csv]
2024-03-08 Project set up in PlatformIO
    Working base project in PlatformIO which incorporates Dave's CurrentSensorBoard3.ino into my existing ESP32 ADC project. No functionality changes, just a base to start with main branch.
2024-04-02 Board bringup: added TPS commands
    [DW_Library.PcbLib, DW_custom_symbols.SchLib, T-B5W519245A-3sets-cc_laser_supply_rev-B.kicad_pcb_bom(2024-01-31).xls, buck-boost-supply.kicad_sch, buck-boost.kicad_sch, cc_laser_supply_rev-B(1).PcbDoc, cc_laser_supply_rev-B.kicad_pcb_bom.csv, cc_laser_supply_rev-B.kicad_pcb_positions.csv]
2024-04-09 Fixed issue with min vout stuck at 1.6V
    [CurrentSensorBoard3.ino, main.cpp, pins.h]
2024-04-09 Working on TPS55289 boost issues
    [buck-boost.kicad_sch, esp32.kicad_sch, fet_and_driver.kicad_sch, peak_detect.kicad_sch]
2024-04-12 Adding PCB issues to be fixed in rev C
    [buck-boost.kicad_sch, esp32.kicad_sch]
2024-04-16 Stopped tracking and removed kicad*.zip files from index
